egueli/SamsungM7_IR/(threads)

Thread 14 (2024-01-21):

JSON deserialization error: NoMemory

martcs, 2024-01-21:
Musiccast Device Yamaha WXC-50 Samsung remote code dont recognize: [ir:UNKNOWN(68)]
Yamaha remote recognizing and showing code. But on sending vol+ or vol- get this:
"[ir:5ea1d827]VOL+ ... JSON deserialization error: NoMemory"
"[ir:RPT]VOL+ ... JSON deserialization error: NoMemory"
On display error code "Ep"
on clock button all work fine, clock showing and disappear on button press.
Can you help please ?

startup message::
 SETUP] WAIT 4...
[SETUP] WAIT 3...
[SETUP] WAIT 2...
[SETUP] WAIT 1...
services map has now 0 entries
serviceToHost map has now 0 entries
hostToAddress map has now 0 entries
Transmit NTP Request
pool.ntp.org: 162.159.200.1
Receive NTP Response
FOUND service 'viesistaba._spotify-connect._tcp.local' at host 'viesistaba.local' with address '192.168.21.100'
speaker ip valid? yes

egueli, 2024-01-22:
Hi @martcs , first of all, thanks for using my project :)

It might be that your WXC-50 replies with a message that is a little too big than the software expects.
Try to change https://github.com/egueli/SamsungM7_IR/blob/2c9111eca6dd40e0afe61c19a8f291702af13bc2/src/speaker_musiccast.cpp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 from 384 to 1024 or even 2048 and try again.

Let me know if that works!

martcs, 2024-01-22:
Hi, thanks for reply.
i try without lucky:
[ir:5ea138c7]Mute: [ir:RPT]JSON deserialization error: NoMemory
[ir:5ea158a7]VOL+ ... [ir:RPT]JSON deserialization error: NoMemory
this showing immediately. Im set 2048 . maybe this is not reply from device, showing too fast. wxc-50 is a little slow, ordinary i set a little pause between http commands, otherwise work just part of code.
what is realy GET string for musiccast? i can tray direct trought browser, and see answer.
im try find in code, but not find. i know http api, but what exactly is the queue for device?

egueli, 2024-01-22:
I doubt it, the "JSON deserialization" happens when receiving a reply from the speaker. When sending, the device performs a serialization.
I realize that several functions specify the deserialization buffer of 384 bytes but I asked you to change only one of them. Could you replace all occurrences of `384` in `musiccast_speaker.cpp` to `2048`? There should be four occurrences.

It would be nice to know how large is response sent by your WXC-50. If you have a Mac or a Linux machine, could you run the following?
```
curl -s "http://192.168.21.100/YamahaExtendedControl/v1/main/getStatus" | wc -c
```
And tell me the number that comes out?

martcs, 2024-01-22:
<html><body>
<!--StartFragment-->
response_code | 0
-- | --
power | "on"
sleep | 0
volume | 75
mute | false
max_volume | 161
input | "optical"
distribution_enable | true
direct | false
enhancer | true
equalizer |  
mode | "manual"
low | 6
mid | 2
high | 3
balance | 0
subwoofer_volume | 0
bass_extension | true
link_control | "speed"
link_audio_delay | "audio_sync_on"
link_audio_quality | "uncompressed"
disable_flags | 0
actual_volume |  
mode | "db"
value | -43
unit | "dB"

<!--EndFragment-->
</body>
</html>

martcs, 2024-01-22:
yes make change from 384 to 2048. response what im paste, get from win pc just IP+/YamahaExtendedControl/v1/main/getStatus

martcs, 2024-01-22:
Sorry, im read again. i missunderstud. read "change in line 167" an only after your last coment get "replace all occurrences". Now all work thanks. only samsung tv remote not work (test with yamaha remote), samsung two remotes show "unknown68", but this is issue IR library i think... thanks again !

martcs, 2024-01-22:
Hi @egueli , i found problem. Remote problem was ir library, as you wrote alowed only NEC protocol. change platformio.ini flags and problem solved. Now all work with samsung tv remote. Only on input change show "deserialization error", but this i dont use.  Thanks again for excellent project!

egueli, 2024-01-23:
Thank you for the feedback! I fixed my code so the NoMemory error doesn't happen anymore.

Great that you fixed the Samsung remote issue. Indeed only the NEC protocol is enabled by default, because my IR receiver was very noisy and getting all sorts of IR codes if I enabled more protocols than I needed.

Closed 2024-01-22.
