egueli/SamsungM7_IR/hardware/board.sch

## EAGLE design hardware/board.sch (2020-02-29, last stored version)

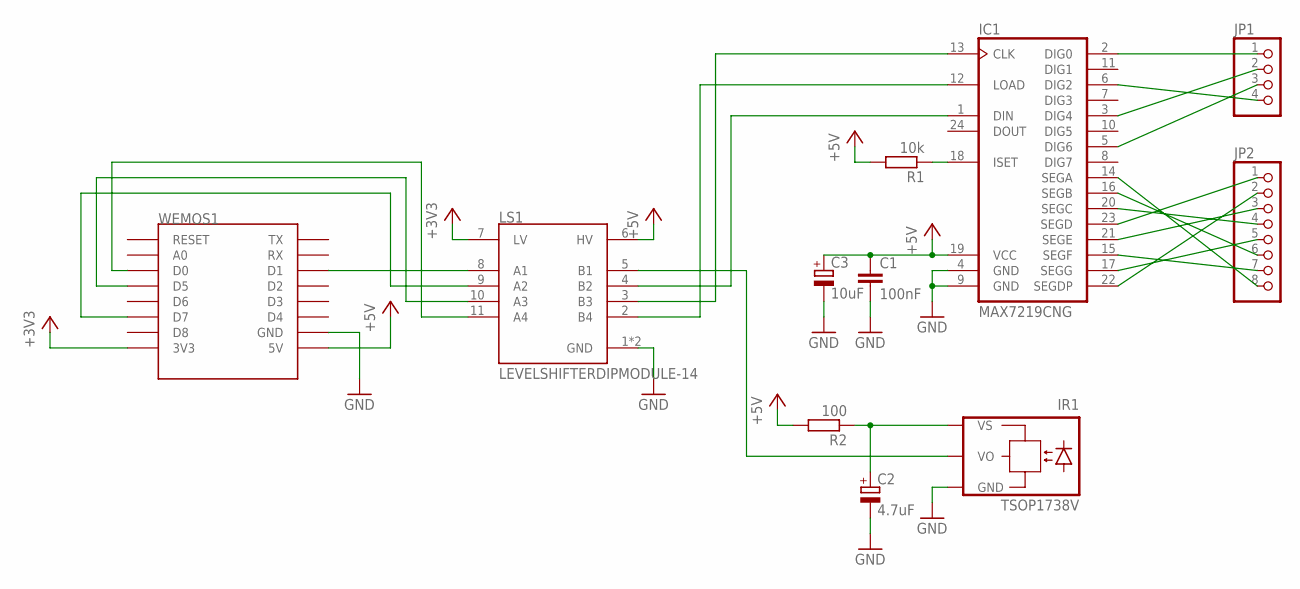
[picture p5: schematic board.sch]

Parts:
C1: 100nF; C050-024X044
C2: 4.7uF; E1,8-4
C3: 10uF; E1,8-4
IC1: MAX7219CNG; DIL24-3
IR1: TSOP1738V; TSOP17_V
JP1: PINHD-1X4; 1X04
JP2: PINHD-1X8; 1X08
LS1: LEVELSHIFTERDIPMODULE-14; DIP1016W53P254L1969H508Q12B
R1: 10k; 0207/10
R2: 100; 0207/10
WEMOS1: WEMOS-D1-MINI

Connections:
+3V3: LS1.7 (LV), WEMOS1.3V3
+5V: C1.1, C3.+, IC1.19 (VCC), LS1.6 (HV), R1.2, R2.2, WEMOS1.5V
GND: C1.2, C2.-, C3.-, IC1.4 (GND), IC1.9 (GND), IR1.GND, LS1.1 (GND), WEMOS1.GND
unnamed: LS1.9 (A2), WEMOS1.D7
unnamed: LS1.10 (A3), WEMOS1.D5
unnamed: LS1.8 (A1), WEMOS1.D1
unnamed: IR1.VO, LS1.5 (B1)
unnamed: IC1.1 (DIN), LS1.4 (B2)
unnamed: IC1.13 (CLK), LS1.3 (B3)
unnamed: IC1.12 (LOAD), LS1.2 (B4)
unnamed: LS1.11 (A4), WEMOS1.D0
unnamed: IC1.18 (ISET), R1.1
unnamed: IC1.2 (DIG0), JP1.1
unnamed: IC1.3 (DIG4), JP1.2
unnamed: IC1.5 (DIG6), JP1.3
unnamed: IC1.6 (DIG2), JP1.4
unnamed: IC1.23 (SEGD), JP2.1
unnamed: IC1.22 (SEGDP), JP2.2
unnamed: IC1.21 (SEGE), JP2.3
unnamed: IC1.20 (SEGC), JP2.4
unnamed: IC1.17 (SEGG), JP2.5
unnamed: IC1.16 (SEGB), JP2.6
unnamed: IC1.15 (SEGF), JP2.7
unnamed: IC1.14 (SEGA), JP2.8
unnamed: C2.+, IR1.VS, R2.1
