egueli/SamsungM7_IR/src/config.h

#pragma once

/*
 * This file collects all user-related configuration.
 * Other configuration is in
 * - wifi_credentials.h for WiFi credentials (not checked in source code) 
 * - board.h for board-specific configuration (pins, display wiring etc.)
 * - config_discovery.cpp for speaker mDNS name (has to be in a .cpp file, not a header)
 */

#include <stdint.h>

/** 
 * The display brightness. Maximum intensity is 255.
 * The precision depends on the display driver: for example, TM1637 has
 * three bits of precision so the lowest number higher than 0 is
 * (1 << (8 - 3)) = 32.
 */
const uint8_t kDisplayBrightness = 64;

/**
 * The display brightness when inactive, e.g. when showing the clock.
 */
const uint8_t kBackgroundDisplayBrightness = 0;

/*
Uncomment this to use the Samsung Multiroom (legacy) instead of
Yamaha MusicCast protocol.
*/
//#define SPEAKER_MULTIROOM

/**
 * Name of the MDNS service identifying a specific speaker. This must be unique in the network.
 * A null value means that any service is OK; one of them will be picked up.
 * The value is defined in config_discovery.cpp.
 */
extern const char *kSpeakerServiceName;

// IR codes for the remote control being used.
#if 1
// My LG TV remote control
const uint64_t kIrVolumeUpCode = 0x20DF40BF;
const uint64_t kIrVolumeDownCode = 0x20DFC03F;
const uint64_t kIrMuteCode = 0x20DF906F;
const uint64_t kIrTvRadCode = 0x20DF0FF0;
const uint64_t kIrToggleClockCode = 0x20DF8679;
#else
// My Acer TV remote control
const uint64_t kIrVolumeUpCode = 0x86C620DF;
const uint64_t kIrVolumeDownCode = 0x86C6A05F;
const uint64_t kIrMuteCode = 0x86C67887;
const uint64_t kIrTvRadCode = 0x86C630CF;
const uint64_t kIrToggleClockCode = 0x20DF8679;
#endif

/** The time zone offset in hours, including DST. e.g. CET is 1 */
const int kTimeZone = 1;

/** Use the 12 hour (ap/pm) time format, 24h otherwise */
const bool kTimeFormat12h = false;
