egueli/SamsungM7_IR/src/ir.cpp

#include <IRrecv.h>
#include <IRremoteESP8266.h>
#include <IRutils.h>

#include "ir.h"
#include "serial.h"
#include "board.h"
#include "config.h"

const uint16_t kIrCaptureBufferSize = 1024;
const uint8_t kIrTimeout = 15;
const uint8_t kIrTolerance = 45;
const uint8_t kIrMaxSkip = 5;
const uint16_t kIrNoiseFloor = 300;

IRrecv irrecv(kIrRecvPin, kIrCaptureBufferSize, kIrTimeout, true);
decode_results results; // can't pass it as parameter to function?

// Holds the last non-repeat IR code. So when IR repeat messages are received, we know
// which code has been repeated. UINT64_MAX means no code has been received yet.
uint64_t currentIrCode = UINT64_MAX;

// Holds the next IR code to call callbacks for, and the repeat flag. Set by peekIR() and consumed by consumeIR().
// If peekIR() decodes multiple messages before consumeIR() is called, only the last
// message should be kept. Once consumerIR() is done with this code, it sets it to UINT64_MAX.
struct {
  uint64_t code;
  bool repeat;
} irCodeToProcess = { UINT64_MAX, false };

void peekIR() {
  bool haveNewMessage = irrecv.decode(&results, NULL, kIrMaxSkip, kIrNoiseFloor);
  if (!haveNewMessage) {
    return;
  }

  if (results.overflow) {
    USE_SERIAL.print("[ir:OVERFLOW]");
    currentIrCode = irCodeToProcess.code = UINT64_MAX;
    return;
  }

  if (results.decode_type != NEC) {
    USE_SERIAL.printf("[ir:UNKNOWN(%d)]", results.rawlen);
    // USE_SERIAL.println();
    // USE_SERIAL.println(resultToSourceCode(&results));
    currentIrCode = irCodeToProcess.code = UINT64_MAX;
    return;
  }

  if (results.repeat) {
    irCodeToProcess = { currentIrCode, true };
    USE_SERIAL.print("[ir:RPT]");
  } else {
    irCodeToProcess = { results.value, false };
    currentIrCode = results.value;
    USE_SERIAL.printf("[ir:%llx]", results.value);
  }
}

void consumeIR() {
  if (irCodeToProcess.code == UINT64_MAX) {
    return;
  }

  switch (irCodeToProcess.code) {
    case kIrVolumeUpCode:
      notifyIR();
      onVolumeUp();
      break;
    case kIrVolumeDownCode:
      notifyIR();
      onVolumeDown();
      break;
    case kIrTvRadCode:
      if (!irCodeToProcess.repeat)
      {
        notifyIR();
        onTvRad();
      }
      break;
    case kIrMuteCode:
      if (!irCodeToProcess.repeat)
      {
        notifyIR();
        onMute();
      }
      break;
    case kIrToggleClockCode:
      if (!irCodeToProcess.repeat)
      {
        onToggleClock();
      }    
    default:
      serialPrintUint64(irCodeToProcess.code, HEX);
      Serial.println();
  }

  irCodeToProcess = { UINT64_MAX, false };
}

void setupIR() {
  irrecv.enableIRIn();  // Start the receiver
  irrecv.setTolerance(kIrTolerance);
}

void loopIR() {
  peekIR();
  consumeIR();
}
