egueli/SamsungM7_IR/src/ir.h

#pragma once

void setupIR();
void loopIR();
void peekIR();

// The functions below are callbacks. Their definition must be in a file other than ir.cpp.
void onVolumeUp();
void onVolumeDown();
void onTvRad();
void onMute();
void onToggleClock();

void notifyIR();
