egueli/SamsungM7_IR/src/use_cases.h

#pragma once

#include "speaker.h"

void increaseVolume(Speaker& speaker);
void decreaseVolume(Speaker& speaker); 
void toggleMute(Speaker &speaker);
void setTvInput(Speaker &speaker);
void toggleClock();
