egueli/SamsungM7_IR/src/http_xml.cpp

#include <Arduino.h>
#include <asyncHTTPrequest.h>

#include "http_xml.h"
#include "http_wait.h"
#include "serial.h"

const unsigned long kHttpTimeout = 5000;

bool parseValueInXML(String document, String &output, String openTag, String closeTag) {
  int openIndex = document.indexOf(openTag);
  if (openIndex == -1) {
    return false;
  }

  int closeIndex = document.indexOf(closeTag, openIndex);
  if (closeIndex == -1) {
    return false;
  }

  output = document.substring(openIndex + openTag.length(), closeIndex);
  return true;
}

bool getValueFromHttp(asyncHTTPrequest &request, String &output, String openTag, String closeTag) {
  unsigned long startAt = millis();

  while (request.readyState() != 4) {
    yield();
    onHttpWait();
    if (millis() - startAt > kHttpTimeout) {
      USE_SERIAL.println("[HTTP] timeout");
      request.abort();
      return false;
    }
  }
  
  int httpCode = request.responseHTTPcode();

  if (httpCode != 200 /* OK */) {
    USE_SERIAL.printf("[HTTP] GET not OK, code: %d\n", httpCode);
    return false;
  }

  String body = request.responseText();
  bool success = parseValueInXML(body, output, openTag, closeTag);
  if (!success) {
    USE_SERIAL.println("[HTTP] unable to read volume");
    return false;
  }

  return true;
}
