egueli/SamsungM7_IR/(commit log)

2020-02-11 output irLoop calls; add pin mappings
2020-02-11 discard IR state in case of overflow or unknown commands; better logging
2020-02-15 fix volume under 0
    [speaker.cpp]
2020-02-29 use new display wire mapping
2020-02-29 fix comment about wifi configuration
    [wifi.cpp]
2020-02-29 add README and schematic
    [board.sch]
2020-03-07 more logging & fixes
    [discovery.cpp]
2020-05-03 add speaker ping & watchdog reset
    [speaker.cpp, speaker.h]
2020-11-19 use original digit wiring as per schematic (it was modified in perfboard)
2020-11-19 free unused pin
2020-11-20 move display wirings to pins.h; readd scan limit
2020-12-10 switch to MusicCast
2020-12-31 let setTvInput also power MusicCast on
2021-01-27 add TM1637 library and driver class
2021-01-27 replace setSetment with builtin macro
    [display.cpp]
2021-01-28 update README with TM1637 stuff
    [board.sch]
2021-02-02 stop caring if failed on a get or a set
    [notify.cpp, notify.h, speaker_samsung_multiroom.cpp, volume.cpp]
2021-02-02 notify failures only at top-level calls
    [main.cpp, notify.cpp, speaker_musiccast.cpp, speaker_samsung_multiroom.cpp, volume.cpp]
2021-02-05 show errors based on cause, not on command
    [display.cpp, main.cpp, notify.cpp, notify.h]
2021-02-07 fix background display rendering
    [display.cpp]
2021-02-07 config 12h time; fix hour padding
    [clock.cpp, config.h]
2021-02-08 toggle clock on/off via remote control button
2021-02-08 fix brief flash when clock is shown
    [display.cpp]
2021-11-07 fix discovery not working
    [discovery.cpp]
2022-09-07 fix build error when using Acer RC
    [config.h]
2024-01-23 increase max size for received JSON response
    This fixes issue #14.
    [speaker_musiccast.cpp]
