egueli/SamsungM7_IR/(notices)

Notices in the files:
README.md:
License: GPL v3
